4ms/pcb-Kit-Trig-Sampler/faceplate/p1/artwork sources/artwork.png

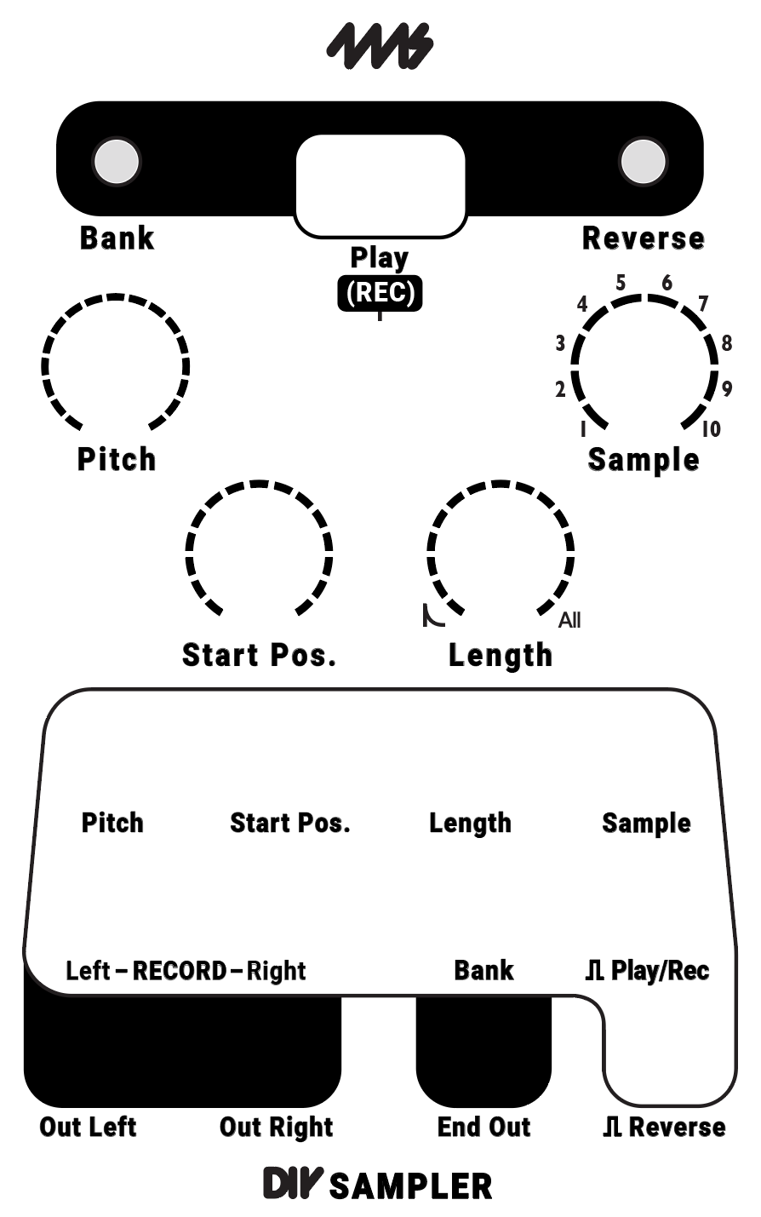
faceplate/p1/artwork sources/artwork.png
