4ms/pcb-Kit-Trig-Sampler/faceplate/p1/artwork sources/DIY_Sampler_JQ3_artwork1.png

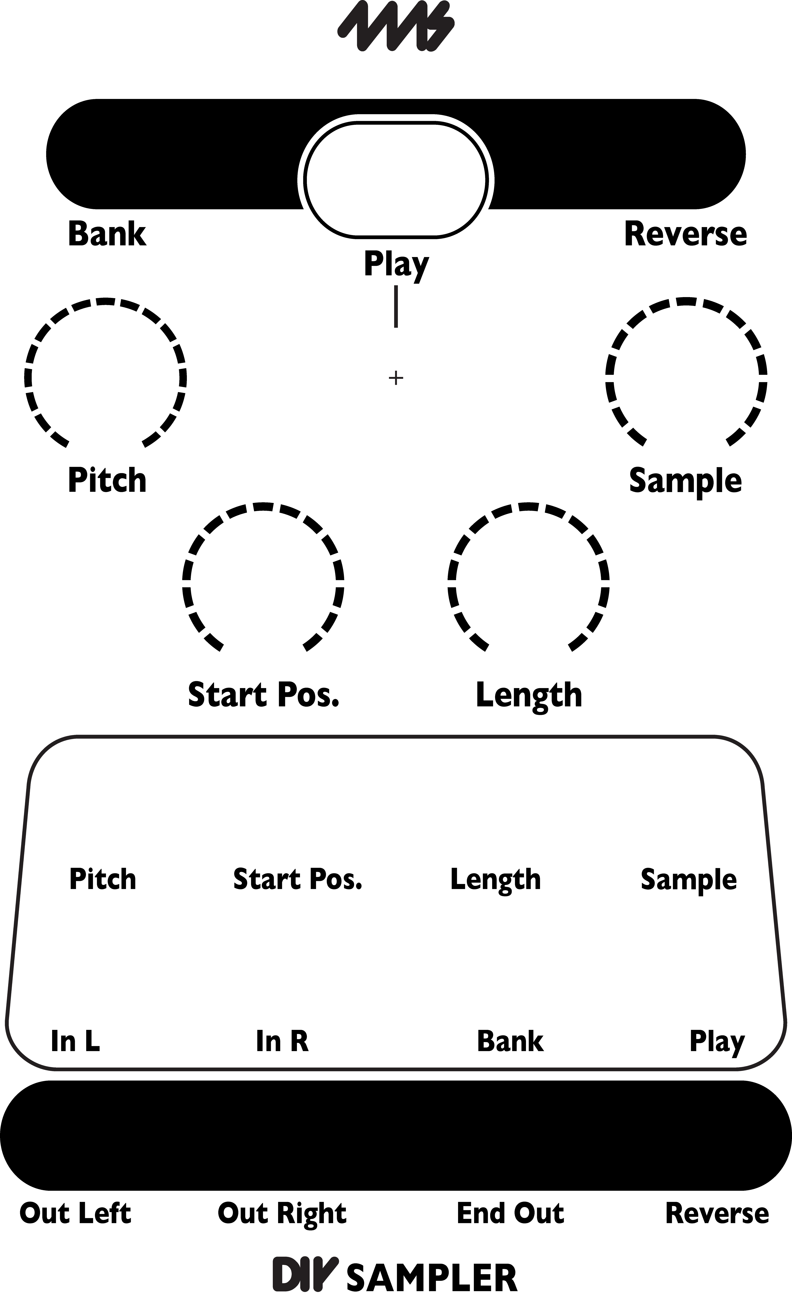
faceplate/p1/artwork sources/DIY_Sampler_JQ3_artwork1.png
