4ms/pcb-Kit-Trig-Sampler/faceplate/p1/artwork sources/DIY_Sampler_JQ8c_artwork.png

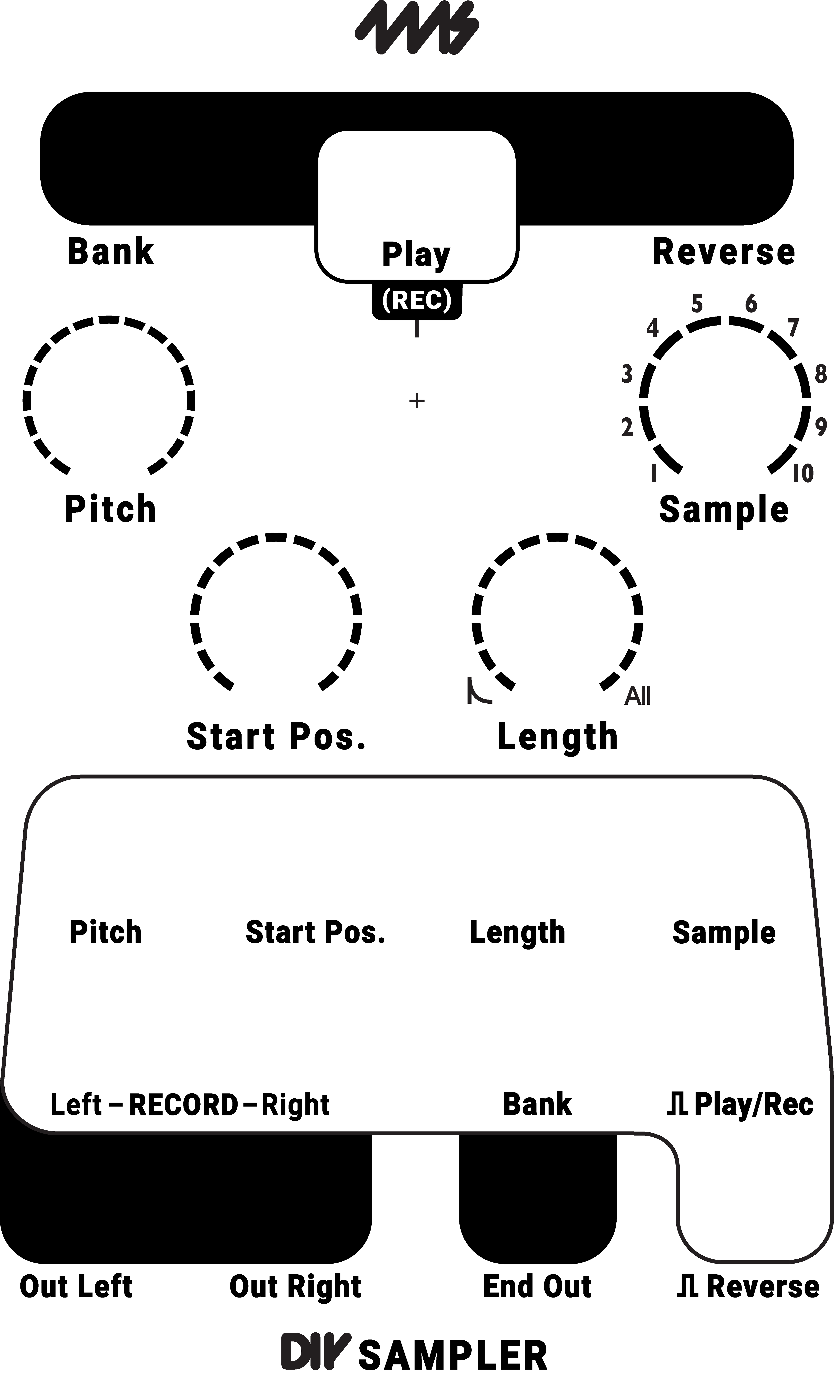
faceplate/p1/artwork sources/DIY_Sampler_JQ8c_artwork.png
