4ms/pcb-Kit-Trig-Sampler/v1.0-kit/kit-sampler-v1.0-project/not used/Kit-Sampler-v1.0-bom-posin.xlsx

Kit-Sampler
4ms Company
PCBA Project: | Kit-Sampler | Revision: | v1.0
EMAIL: | 4ms@4mscompany.com
DATE: | 2023-03-28
Group | Item# | Manufacturer | Manufacter Part# | Designator | Quantity | Designation | Package | Comments | Supplied by:
A | 1 |  |  |  | 1 | Plastic Bag with zip closure. Width: 50mm-90mm, Height: 75mm-150mm. |  |  | Posin
B | 2 | Vishay | K104Z15Y5VF53L2 | C1, C2, C3, C7, C8, C9, C10, C12, C13, C14, C15, C16, C17 | 13 | 0.1uF_Disc_TH, MLCC, Leaded, Min 25V, Y5V, Lead Spacing 2.5mm, Body approx 4x4mm | C_Disc_P2.54mm |  | Posin
B | 3 | Panasonic | ECA-1VM470I | C4, C5, C19, C20 | 4 | 47uF_16V_TH, Aluminum Electrolytic, Radial Leaded, Min 25V, 5mm Diameter, 11mm Height, 2.5mm Lead Spacing | CP_Radial_P2.5mm |  | Posin
B | 4 | Nichicon | QYX2A102KTP1FD | C6 | 1 | 1nF_Disc_TH, Film Capacitor, Min 25V, Max 20% tolerance, Lead Spacing 5mm, Body 5mm(W) x 8.5mm(H) | C_Disc_P5.08mm |  | Posin
B | 5 | Vishay | D101K20Y5PL6TJ5R | C11 | 1 | 100pF_Disc_TH, Ceramic Disc, Max 20% tolerance, 5mm Lead Spacing, 5mm Diameter | C_Disc_P5.08mm |  | Posin
B | 6 | Vishay | SB140-E3/54 | D1, D2 | 2 | SB140-E3_TH, SCHOTTKY RECTIFIER 1.0A 40Vrrm 0.48Vf | D_DO-35_P7.62mm_Horizontal |  | Posin
B | 7 | TAD | 1-1002FBV0T | J14 | 1 | Eurorack_Power_10pin_Unshrouded, HEADER 2x5 MALE PINS 0.100” 180deg | Pins_2x05_2.54mm_TH_Europower |  | Posin
B | 8 | Samtec | SSW-105-01-T-D | JA1, JB1, JC1, JD1 | 4 | Socket_02x05_P2.54mm_TH, HEADER 2x5 FEMALE SOCKET 0.100” 180deg | Socket_2x05_2.54mm_TH |  | Posin
B | 9 | Xicon | 299-1k-RC | R1, R15, R16, R21, R40, R41 | 6 | 1k_TH0.125, 1k, 5%, 1/8W, TH0.125 | R_Axial_DIN0207_L6.3mm_D2.5mm_P7.62mm_Horizontal |  | Posin
B | 10 | Xicon | 299-47k-RC | R2, R3, R4, R14, R17, R20, R27, R33 | 8 | 47k_TH0.125, 47k, 5%, 1/8W, TH0.125 | R_Axial_DIN0207_L6.3mm_D2.5mm_P7.62mm_Horizontal |  | Posin
B | 11 | Xicon | 299-100k-RC | R5, R6, R7, R8, R34 | 5 | 100k_TH0.125, 100k, 5%, 1/8W, TH0.125 | R_Axial_DIN0207_L6.3mm_D2.5mm_P7.62mm_Horizontal |  | Posin
B | 12 | Xicon | 299-10k-RC | R9, R12, R25, R26, R37 | 5 | 10k_TH0.125, 10k, 5%, 1/8W, TH0.125 | R_Axial_DIN0207_L6.3mm_D2.5mm_P7.62mm_Horizontal |  | Posin
B | 13 | Xicon | 299-33k-RC | R10, R11, R13, R28, R30, R31, R32 | 7 | 33k_TH0.125, 33k, 5%, 1/8W, TH0.125 | R_Axial_DIN0207_L6.3mm_D2.5mm_P7.62mm_Horizontal |  | Posin
B | 14 | Xicon | 299-330-RC | R18, R19, R23 | 3 | 330Ω_TH0.125, 330Ω, 5%, 1/8W, TH0.125 | R_Axial_DIN0207_L6.3mm_D2.5mm_P7.62mm_Horizontal |  | Posin
C | 15 | TE Connectivity | 1-2199298-2 | SK1, SK2 | 2 | DIP-8 Socket, 2.54mm Pitch, 7.62mm Rows |  |  | Posin
C | 16 | Texas Instruments | TL072IP | U1, U2 | 2 | TL072_TH, Dual Opamp DIP-8 JFET Input, Low Noise, Min 24Vpp Vsupply, 13V/us, 3MHz GBP | DIP-8pin_TH |  | Posin
D | 17 | Posin | kit-sampler-faceplate-v1.0 | FP1 | 1 | Faceplate, Kit Sampler Faceplate, matte black mask, white silk |  |  | Posin
D | 18 | Posin | kit-sampler-v1.0 | PCB1 | 1 | PCB, green mask, white silk, FR4 1.6mm, HASL-LF, two layer |  |  | Posin
