4ms/pcb-Kit-Trig-Sampler/faceplate/p1/artwork sources/DIY_Sampler_JQ5.dxf

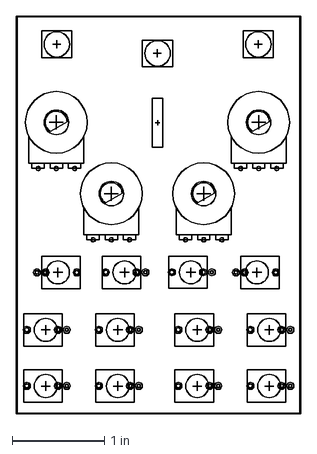
[picture p5: CAD file, 2023-01-18]
faceplate/p1/artwork sources/DIY_Sampler_JQ5.dxf
3.08 x 4.31 in
