4ms/pcb-Kit-Trig-Sampler/faceplate/p1/artwork sources/DIY_Sampler_JQ4.dxf

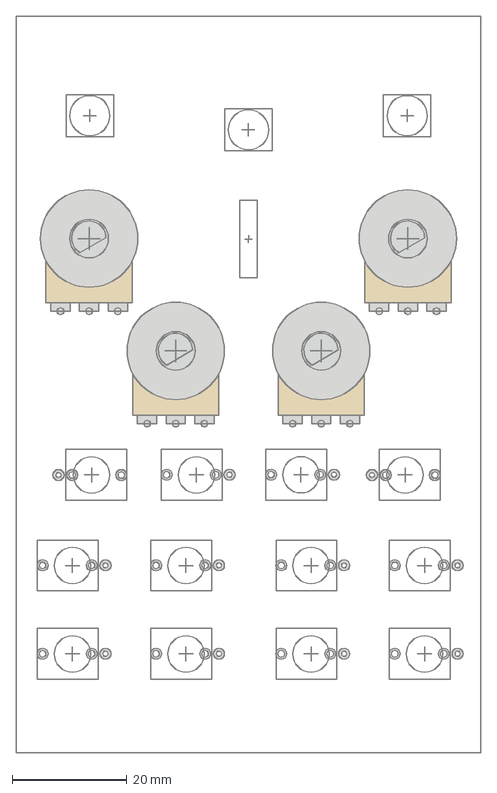
[picture p6: CAD file, 2023-01-17]
faceplate/p1/artwork sources/DIY_Sampler_JQ4.dxf
81.0 x 128.5 mm
