4ms/pcb-Kit-Trig-Sampler/faceplate/p1/artwork sources/DIY_Sampler_JQ3_mount1.dxf

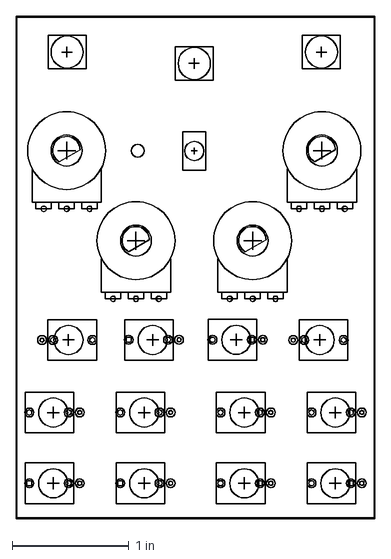
[picture p7: CAD file, 2023-01-17]
faceplate/p1/artwork sources/DIY_Sampler_JQ3_mount1.dxf
3.08 x 4.31 in
