4ms/pcb-Kit-Trig-Sampler/v1.0-kit/kit-sampler-v1.0-project/not used/instructions.pdf

### Kit-Sampler Parts Instructions

See BOM column "Group".

1) Group B (resistors, capacitors, diodes, headers) placed into a clear plastic bag (Item 1)
2) Group C (Items 15 and 16: ICs and IC sockets) placed on foam OR placed in IC tube:

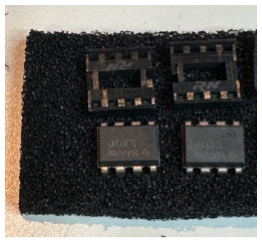
[picture p8: figure]
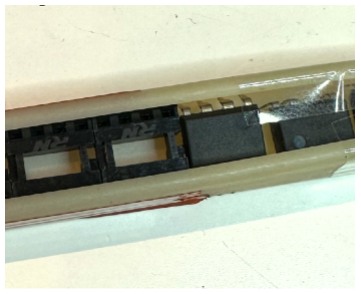
[picture p9: figure]

3) Group C placed into plastic bag (Item 1). Photo shows foam option.

Foam or tube is OK.

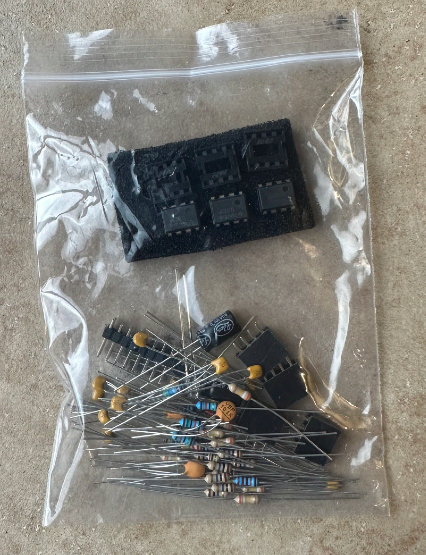
[picture p10: figure]

4) PCBs and faceplate PCBs (Items 17 and 18) can be shipped together in bulk

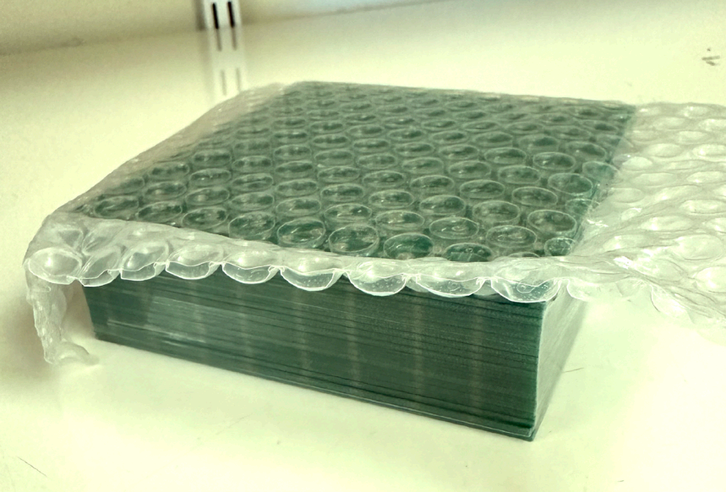
[picture p11: figure]
