4ms/pcb-Kit-Trig-Sampler/(threads)

Thread 1 (2023-03-21):

Play Trig jack need to be on protected pin

danngreen, 2023-03-21:
on p3, Play Trig jack goes to D13. But this pin is not protected on the brainboard. So it needs to change to D0, D1, D2, or D3.
D0 is Bank LED Green
D1 is Bank LED Red
D2 is already used by the other trigger input (Rev).
D3 is Rev LED Blue

Here's one solution:

Change Bank Button (D6) to use D13
Change Play Trig (D13) to use D0
Change Bank LED Green (D0) to use D6

Alternatively, we could leave the brainboard connections the same and add a 1k resistor, a 10nF cap, and two diodes to the Kit PCB (same setup as the 2k resistor and BAT54 on the brainboard D0 pin). But this is more parts and swapping the pins is better in the long run

danngreen, 2023-03-21:
Here's another solution:
We could just add a 1k resistor to the Sampler Kit PCB in series with the Play jack. This could be done on the protos that arrive this week easily (requires cutting the trace, though).
Then we add a BAT54S on the brain boards on pin D13. This does not require any trace-cutting, just soldering the BAT54S to the pin header and running wires to GND and +3.3V.

danngreen, 2023-03-21:
We have a similar issue on the LD too...

danngreen, 2023-03-21:
Chosen Solution:
Add 10k resistor on Sampler Kit in series with Play Jack.
Add BAT54S on pin D13 on brainboards. Also add more BAT54S on other digital pins

danngreen, 2023-03-23:
Actually, we are adding 47k resistors, not 10k to all Trigger input jacks

danngreen, 2023-03-24:
Fixed on p5 brainboards, and p3/p3-SMT Samplers

danngreen, 2023-03-26:
Cut traces and add 47k to on sampler-p2 unit that arrived March 24

Closed 2023-03-26.

Thread 2 (2023-03-23):

Pitch CV range should be more favored towards higher pitches

danngreen, 2023-03-23:
Currently is -5V to +5V, but -2 to +8V would be better.

Changing the offset resistor would fix it

danngreen, 2023-03-29:
Tried it out on a branch, by using a 47k instead of R9+R37(10k+10k). Makes the pitch CV respond from -2.25V to +7.75V. Adjusted volt oct compensation and lookup table.
Unable to play stereo 16b samples past around 4-5 octaves up anyways.

Doing this would allow you to turn the Pitch knob all the way down and then use CV to go up 8 octaves, but with the pitch knob centered it glitches too much.

Closing, no changes will be made

Closed 2023-03-29.
