4ms/pcb-Kit-Trig-Sampler/v1.0-kit/pdf/DIY-Sampler-Kit-schematic.pdf

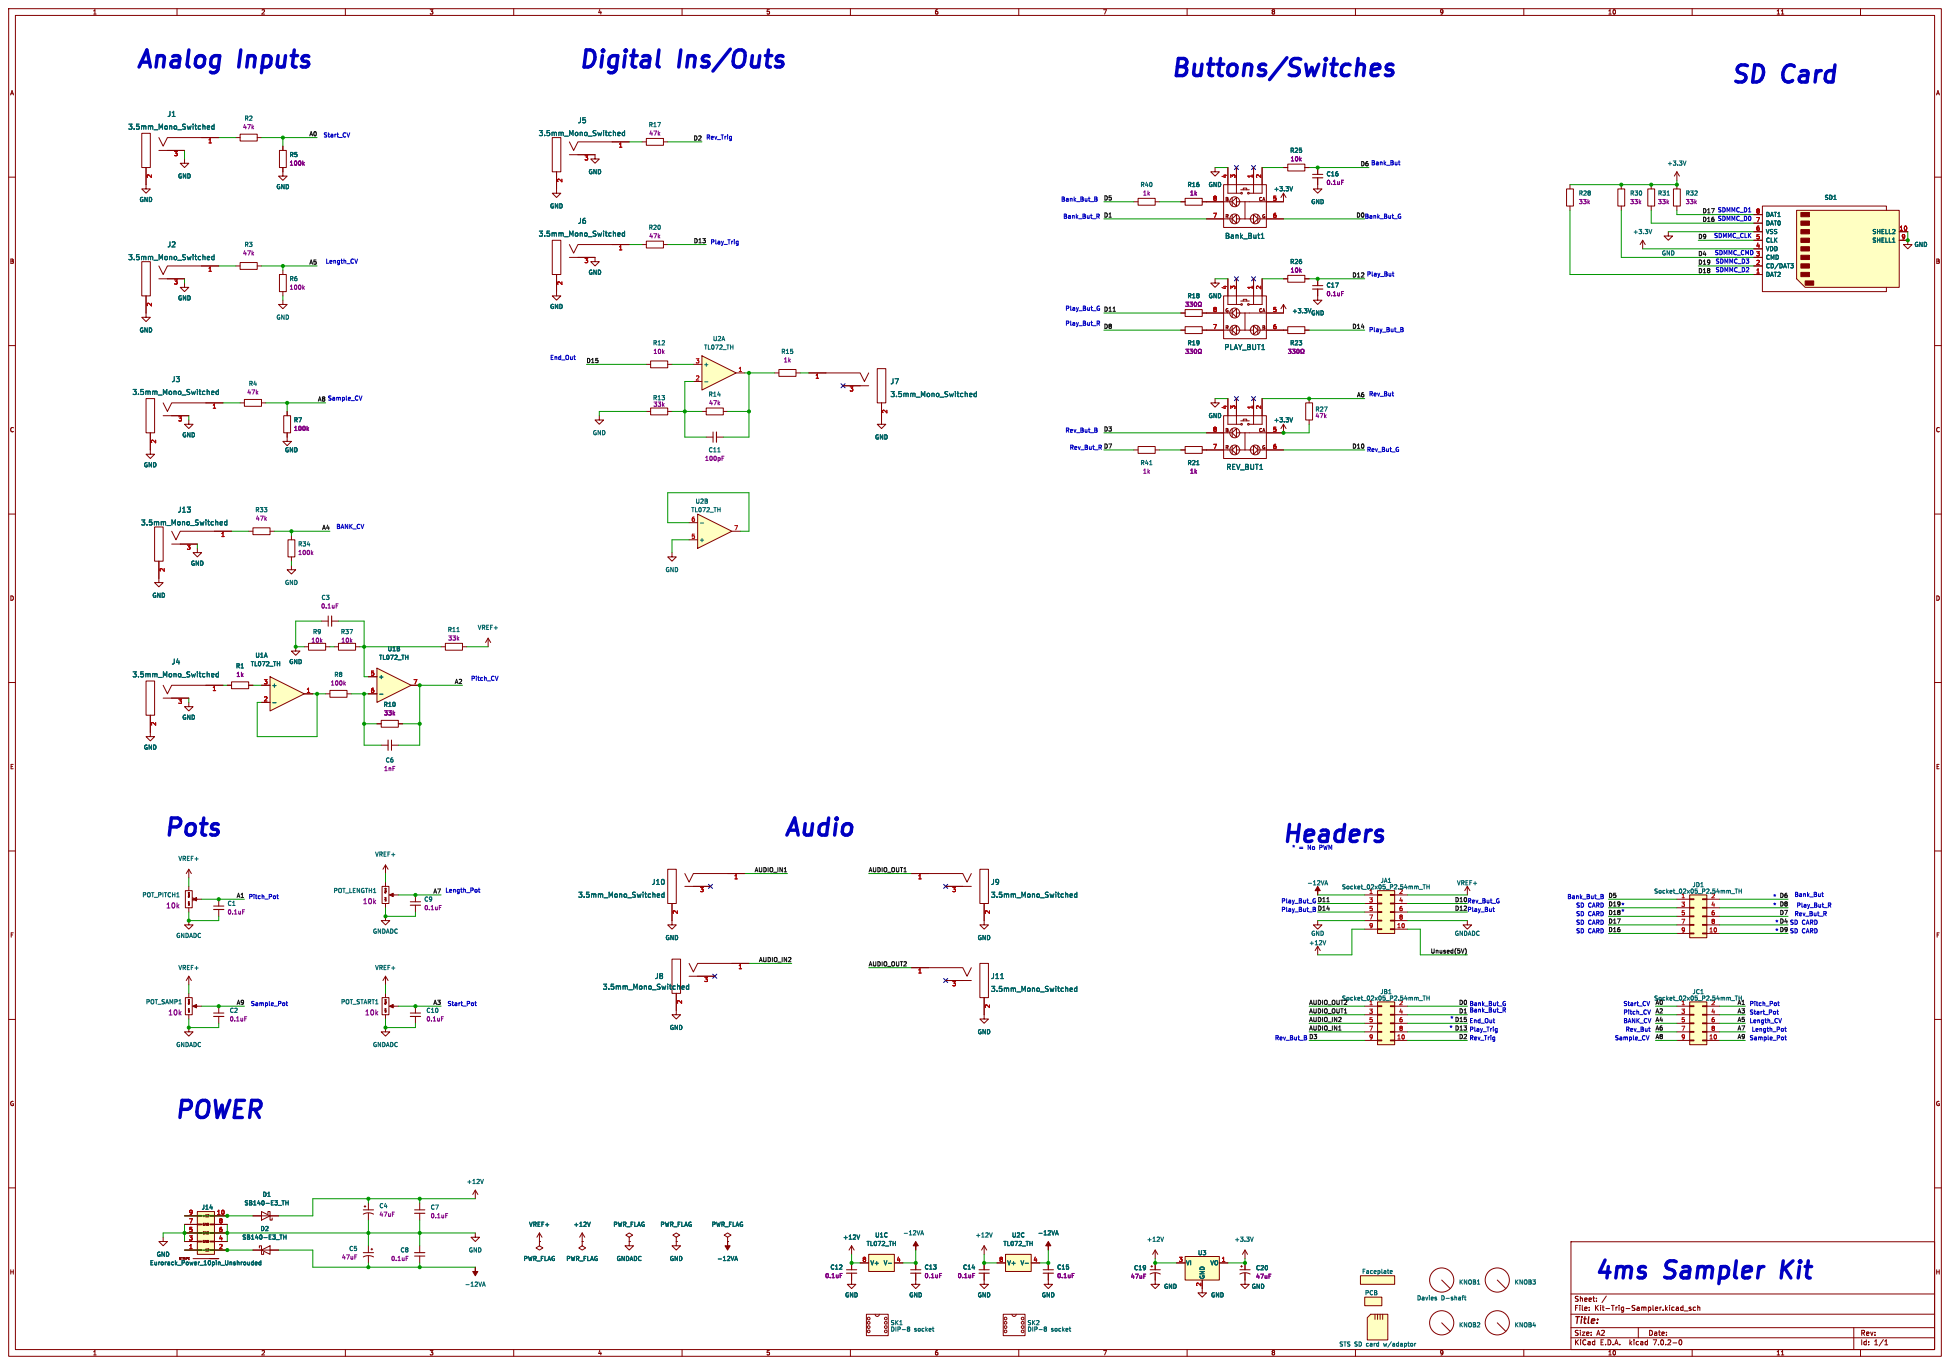
[picture p12: page 1]

STS SD card w/adaptor
