4ms/pcb-Kit-Trig-Sampler/(commit log)

2022-10-17 Started Schematic
    Updated all parts to current 4ms library
    [Kit-Trig-Sampler.kicad_pcb, Kit-Trig-Sampler.kicad_sch]
2023-01-05 STS kit
    schematic drawin
    [Kit-Trig-Sampler.kicad_pcb, Kit-Trig-Sampler.kicad_sch]
2023-01-05 forgotten push
    [Kit-Trig-Sampler.kicad_sch]
2023-01-05 part placement
    [Kit-Trig-Sampler.kicad_pcb, Kit-Trig-Sampler.kicad_sch]
2023-01-05 Small changes to pin assignments
    [Kit-Trig-Sampler.kicad_pcb, Kit-Trig-Sampler.kicad_sch]
2023-01-05 added Bank cv
    [Kit-Trig-Sampler.kicad_pcb, Kit-Trig-Sampler.kicad_sch]
2023-01-06 part placement ip
    [Kit-Trig-Sampler.kicad_pcb, Kit-Trig-Sampler.kicad_sch]
2023-01-09 part placement pending approval
    [Kit-Trig-Sampler.kicad_pcb]
2023-01-09 small updates
    [Kit-Trig-Sampler.kicad_pcb, Kit-Trig-Sampler.kicad_sch]
2023-01-09 ignore .kicad_prl files
2023-01-10 Finished routing
    needs a once over and silk arrangement.
    [Kit-Trig-Sampler.kicad_pcb, Kit-Trig-Sampler.kicad_sch]
2023-01-11 finished routing and silk arrangement
    ready for review
    [Kit-Trig-Sampler.kicad_pcb]
2023-01-13 nudged some parts in accordance to FP update
    [Kit-Trig-Sampler.kicad_pcb, Kit-Trig-Sampler.kicad_sch]
2023-01-13 nudged some parts for to match DLD layout
    [Kit-Trig-Sampler.kicad_pcb]
2023-01-14 small update to silk
    [Kit-Trig-Sampler.kicad_pcb]
2023-01-17 fixed artwork files (JQ revision 3)
    [DIY_Sampler_JQ3_mount1.dxf]
2023-01-17 Added rev4 artwork AI and DXF
    [DIY_Sampler_JQ4.dxf]
2023-01-17 updates to part placement
    so it matches the faceplate
    [Kit-Trig-Sampler.kicad_pcb]
2023-01-18 Rev5 of Artwork
    [DIY_Sampler_JQ5.dxf]
2023-01-18 created faceplate p1 project
    [Kit-Trig-Sampler-faceplate.kicad_pcb]
2023-01-18 JLCPCB prep
    [Kit-Trig-Sampler.kicad_pcb, bom.csv, designators.csv, positions.csv]
2023-01-20 changes to schem and layout
    [Kit-Trig-Sampler.kicad_pcb, Kit-Trig-Sampler.kicad_sch]
2023-01-20 updates to PCB. arrangement of silk.
    [Kit-Trig-Sampler.kicad_pcb]
2023-01-23 Fixed R13 value (was 68k, should be 33k)
    [Kit-Trig-Sampler.kicad_sch]
2023-01-23 Resistor Consolidation
    and updates to Button LEDS
    [Kit-Trig-Sampler.kicad_pcb, Kit-Trig-Sampler.kicad_sch]
2023-01-23 Resistor consolidation
    [Kit-Trig-Sampler.kicad_pcb]
2023-01-25 minor changes to silk
    [Kit-Trig-Sampler.kicad_pcb, bom.csv, designators.csv, positions.csv]
2023-02-18 p2 started
    [Kit-Trig-Sampler-faceplate.kicad_pcb, Kit-Trig-Sampler.kicad_pcb, Kit-Trig-Sampler.kicad_sch, bom.csv, designators.csv, positions.csv]
2023-02-18 Rotated power header
    repositioned R13 and 47uF caps at top of board
    [Kit-Trig-Sampler.kicad_pcb]
2023-03-06 power header swapped for 10 pin
    [Kit-Trig-Sampler.kicad_pcb, Kit-Trig-Sampler.kicad_sch]
2023-03-06 Moved p1 artwork files to faceplate/p1 folder
    [DIY_Sampler_JQ3_mount1.dxf, DIY_Sampler_JQ4.dxf, DIY_Sampler_JQ5.dxf]
2023-03-06 Fix audio jack positions on schematic
    [Kit-Trig-Sampler.kicad_sch]
2023-03-06 Added note about D5 going to two LEDs
    [Kit-Trig-Sampler.kicad_sch]
2023-03-07 Assigned Rev_But_B to pin D3 (instead of D5, which is used by Bank_But_B)
    [Kit-Trig-Sampler.kicad_sch]
2023-03-07 Fixed D5 redundancy
    [Kit-Trig-Sampler.kicad_pcb, Kit-Trig-Sampler.kicad_sch]
2023-03-07 updated p2 faceplate
    [Kit-Trig-Sampler-FACEPLATE-B_Cu.gbl, Kit-Trig-Sampler-FACEPLATE-B_Mask.gbs, Kit-Trig-Sampler-FACEPLATE-Edge_Cuts.gm1, Kit-Trig-Sampler-FACEPLATE-F_Cu.gtl, Kit-Trig-Sampler-FACEPLATE-F_Mask.gts, Kit-Trig-Sampler-FACEPLATE-F_Silkscreen.gto, Kit-Trig-Sampler-FACEPLATE-drl_map.gbr, Kit-Trig-Sampler-FACEPLATE-job.gbrjob]
2023-03-11 STS P2 updated to fix LED brightness issue on buttons
    [Kit-Trig-Sampler.kicad_pcb, Kit-Trig-Sampler.kicad_sch]
2023-03-13 Rev But gets pull-up, no cap. Remove SD-D3 resistor
    [Kit-Trig-Sampler.kicad_sch]
2023-03-13 P2: updates from schem, rerouted GND near 3v3. Rotated SD card 180
    [Kit-Trig-Sampler.kicad_pcb]
2023-03-13 P2: updated from schem, rerouted GND near 3v3. Rotated SD card 180
    [Kit-Trig-Sampler.kicad_pcb]
2023-03-17 p2: generated production files
    [bom.csv, designators.csv, positions.csv]
2023-03-17 p2: regenerated prodcution files...
    [Kit-Trig-Sampler.kicad_pcb]
2023-03-17 P2-SMT: conversion and pcb complete +faceplate
    [Kit-Trig-Sampler-FACEPLATE-B_Cu.gbl, Kit-Trig-Sampler-FACEPLATE-B_Mask.gbs, Kit-Trig-Sampler-FACEPLATE-B_Paste.gbp, Kit-Trig-Sampler-FACEPLATE-B_Silkscreen.gbo, Kit-Trig-Sampler-FACEPLATE-Edge_Cuts.gm1, Kit-Trig-Sampler-FACEPLATE-F_Cu.gtl, Kit-Trig-Sampler-FACEPLATE-F_Mask.gts, Kit-Trig-Sampler-FACEPLATE-F_Paste.gtp]
2023-03-20 Small tweeks to p2 smt routing
    [Kit-Trig-Sampler.kicad_pcb]
2023-03-20 p2-SMT nudged traces to keep PWMs away from CV jacks
    [Kit-Trig-Sampler.kicad_pcb]
2023-03-21 p2 SMT: swapped out U3 for different regulator
    [Kit-Trig-Sampler.kicad_pcb, Kit-Trig-Sampler.kicad_sch]
2023-03-22 changed the p number to 3 on SMT version so it'll be in synch with non-smt
    [Kit-Trig-Sampler.kicad_pcb, Kit-Trig-Sampler.kicad_sch, bom.csv, designators.csv, positions.csv]
2023-03-22 created p3
    [Kit-Trig-Sampler.kicad_pcb, Kit-Trig-Sampler.kicad_sch, bom.csv, designators.csv, positions.csv]
2023-03-22 p3: added 47k resistors to Trig Ins
    [Kit-Trig-Sampler.kicad_pcb, Kit-Trig-Sampler.kicad_sch]
2023-03-22 p3 SMT: added 47K resistors to Trig Ins
    [Kit-Trig-Sampler.kicad_pcb, Kit-Trig-Sampler.kicad_sch]
2023-03-22 p2 smt: regenerated fp
    [Kit-Trig-Sampler-FACEPLATE-B_Cu.gbl, Kit-Trig-Sampler-FACEPLATE-B_Mask.gbs, Kit-Trig-Sampler-FACEPLATE-B_Paste.gbp, Kit-Trig-Sampler-FACEPLATE-B_Silkscreen.gbo, Kit-Trig-Sampler-FACEPLATE-Edge_Cuts.gm1, Kit-Trig-Sampler-FACEPLATE-F_Cu.gtl, Kit-Trig-Sampler-FACEPLATE-F_Mask.gts, Kit-Trig-Sampler-FACEPLATE-F_Paste.gtp]
2023-03-22 p3: generated production files
    [Kit-Trig-Sampler.kicad_pcb]
2023-03-22 p3 smt: generated prod files
    [Kit-Trig-Sampler.kicad_pcb, bom.csv, designators.csv, positions.csv]
2023-03-22 p3 smt: redid faceplate
    [Kit-Trig-Sampler-FACEPLATE-B_Cu.gbl, Kit-Trig-Sampler-FACEPLATE-B_Mask.gbs, Kit-Trig-Sampler-FACEPLATE-Edge_Cuts.gm1, Kit-Trig-Sampler-FACEPLATE-F_Cu.gtl, Kit-Trig-Sampler-FACEPLATE-F_Mask.gts, Kit-Trig-Sampler-FACEPLATE-F_Silkscreen.gto, Kit-Trig-Sampler-FACEPLATE-drl_map.gbr, Kit-Trig-Sampler-FACEPLATE-job.gbrjob]
2023-03-28 WIP: idea for SMT version with no brainboard
    [Kit-Trig-Sampler.kicad_pcb, Kit-Trig-Sampler.kicad_sch, bom.csv, designators.csv, positions.csv]
2023-03-29 updating sch with BOM info
    [Kit-Trig-Sampler.kicad_sch]
2023-03-29 Update instructions.pdf, update BOM, export Gerbers
    [Kit-Sampler-v1.0-bom-posin.xlsx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]
2023-03-29 faceplate p3: Fix DIY marking more legible
    [Kit-Sampler-faceplate-B_Cu.gbl, Kit-Sampler-faceplate-B_Mask.gbs, Kit-Sampler-faceplate-Edge_Cuts.gm1, Kit-Sampler-faceplate-F_Cu.gtl, Kit-Sampler-faceplate-F_Mask.gts, Kit-Sampler-faceplate-F_Silkscreen.gto, Kit-Sampler-faceplate-drl_map.gbr, Kit-Sampler-faceplate.drl]
2023-03-29 Add gerbers to send to Posin
2023-03-29 Create p3 kit project files for Posin
    [Kit-Sampler-v1.0-bom-posin.xlsx]
2023-03-29 p3-SMT: Updated all syms from lib
    [Kit-Trig-Sampler.kicad_sch]
2023-03-29 p3-SMT: update socket symbols, add PCB/faceplate/knob symbols
    [Kit-Trig-Sampler.kicad_sch]
2023-03-29 p3-SMT: generate BOM (first pass)
    [Kit-Trig-Sampler.csv]
2023-03-29 finish p3-SMT BOM. Update all headers to non-gold
    [Kit-Sampler-v1.0-bom-posin.xlsx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]
2023-04-06 Created v1.0 kit and built (aka p4-SMT).
    kit: fixed footprint for regulator
    built: also fixed footprint/connections for regulator
    updated silk to say 1.0
    [Kit-Sampler-v1.0-bom-posin.xlsx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]
2023-04-06 Rename p4-SMT => v1.0-built
    [Kit-Trig-Sampler-B_Cu.gbr, Kit-Trig-Sampler-B_Mask.gbr, Kit-Trig-Sampler-B_Silkscreen.gbr, Kit-Trig-Sampler-Edge_Cuts.gbr, Kit-Trig-Sampler-F_Cu.gbr, Kit-Trig-Sampler-F_Mask.gbr, Kit-Trig-Sampler-F_Paste.gbr, Kit-Trig-Sampler-F_Silkscreen.gbr]
2023-04-06 Renamed "Kit-Trig-Sampler" SMT => Sampler-built
    [Kit-Trig-Sampler-all-pos.csv, Sampler-built-B_Cu.gbr, Sampler-built-B_Mask.gbr, Sampler-built-B_Silkscreen.gbr, Sampler-built-Edge_Cuts.gbr, Sampler-built-F_Cu.gbr, Sampler-built-F_Mask.gbr, Sampler-built-F_Paste.gbr]
2023-04-06 Add BOM costs for v1.0 kit and built
    [Kit-Sampler-v1.0-bom-posin_(20230404 cost).xlsx, Sampler-v1.0-bom-posin_(20230331 cost).xlsx]
2023-04-10 Faceplate p3 smt: corrections to faceplate.
    fixed sd card slot size
    [Kit-Trig-Sampler-FACEPLATE-B_Cu.gbl, Kit-Trig-Sampler-FACEPLATE-B_Mask.gbs, Kit-Trig-Sampler-FACEPLATE-Edge_Cuts.gm1, Kit-Trig-Sampler-FACEPLATE-F_Cu.gtl, Kit-Trig-Sampler-FACEPLATE-F_Mask.gts, Kit-Trig-Sampler-FACEPLATE-F_Silkscreen.gto, Kit-Trig-Sampler-FACEPLATE-job.gbrjob, Kit-Trig-Sampler-FACEPLATE.drl]
2023-04-11 Added zip file of p3-smt faceplate (Sampler-faceplate-v1.0a)
2023-04-11 v1.0-kit: updated BOM (new TH part numbers to match what we actually use)
    [Kit-Trig-Sampler.kicad_sch]
2023-04-18 Kit BOM updated with parts we have in stock
2023-04-18 Updated kit BOM with actual parts used
2023-04-27 Renamed faceplate/p3-smt => faceplate/v1.0-built
    [Kit-Trig-Sampler-FACEPLATE-B_Cu.gbl, Kit-Trig-Sampler-FACEPLATE-B_Mask.gbs, Kit-Trig-Sampler-FACEPLATE-Edge_Cuts.gm1, Kit-Trig-Sampler-FACEPLATE-F_Cu.gtl, Kit-Trig-Sampler-FACEPLATE-F_Mask.gts, Kit-Trig-Sampler-FACEPLATE-F_Silkscreen.gto, Kit-Trig-Sampler-FACEPLATE-job.gbrjob, Kit-Trig-Sampler-FACEPLATE.drl]
2023-04-27 Renamed faceplate/p3 => faceplate/v1.0-kit
    [Kit-Sampler-faceplate-B_Cu.gbl, Kit-Sampler-faceplate-B_Mask.gbs, Kit-Sampler-faceplate-Edge_Cuts.gm1, Kit-Sampler-faceplate-F_Cu.gtl, Kit-Sampler-faceplate-F_Mask.gts, Kit-Sampler-faceplate-F_Silkscreen.gto, Kit-Sampler-faceplate-drl_map.gbr, Kit-Sampler-faceplate.drl]
2023-04-27 BOM cleanup/organization
2024-03-19 V1.1-rc-1-12HP
    created folder, updated schem, suggested layout
    [Sampler-built-B_Cu.gbr, Sampler-built-B_Mask.gbr, Sampler-built-B_Silkscreen.gbr, Sampler-built-Edge_Cuts.gbr, Sampler-built-F_Cu.gbr, Sampler-built-F_Mask.gbr, Sampler-built-F_Paste.gbr, Sampler-built-F_Silkscreen.gbr]
2024-03-20 v1.0 kit schematic PDF
2024-03-20 Proofed and fixed v1.1rc1_12HP schematic. Some schematic TODO left
    [Sampler-built.kicad_sch]
2024-03-21 v1.1-rc1-12HP: part placement and routing ip
    [Sampler-built.kicad_pcb, Sampler-built.kicad_sch]
2024-03-21 v1.1 rc1 12hp: routing IP
    [Sampler-built.kicad_pcb]
2024-04-02 v1.1-rc1-12HP: finished routing and silk
    [Sampler-built.kicad_pcb]
2024-04-02 Removed extra EdgeCuts line
    [Sampler-built.kicad_pcb]
2024-04-05 Re-routing in progress
    TODO:
    - A2 (PitchCV) on red layer, routing CCW from ARM pin to opamp, avoiding digital lines
    - Put SAI/I2C traces that are north of ARM => to orange layer
    - Put digital red traces in the area under the START1_POT => to blue/orange layer
    - Move VREF/GNDADC to red layer (might need to go to orange layer when crossing board east->west
    - Move U6 to near V2, using the nettie for GNDADC-GND for U6
    [Sampler-built.kicad_pcb, Sampler-built.kicad_sch]
2024-04-05 Updates to pcb / routing for noise mitigation
    [Sampler-built.kicad_pcb, Sampler-built.kicad_sch]
2024-04-08 Routing: Moved all digital traces under START POT to blue layer
    Simplified lots of digital routing in that area
    Made analog routing more strictly stay on red side
    Moved VREF/GNDADC connection to ARM away from inductor
    [Sampler-built.kicad_pcb]
2024-04-09 Minor Schem cleanup
    only changes to clean up appearance, no changes to routing
    [Sampler-built.kicad_sch]
2024-04-09 12HP-v1.1rc1 faceplate - Finished artwork, exported PNG, converted to footprint
    [Sampler-built.kicad_sch]
2024-04-10 Set kicad.pro file back to kicad v7
2024-04-10 SCH: Updated STM chip (U2) to use new library part.
    Set kicad.sch file back to v7
    [Sampler-built.kicad_sch]
2024-04-10 PCB: Fixed copper pour glitch, reconnected 3.3v, added Screen to silk and resolved DRC
    [Sampler-built.kicad_pcb]
2024-04-10 Generated production files
    [Sampler-built-B_Cu.gbr, Sampler-built-B_Mask.gbr, Sampler-built-B_Silkscreen.gbr, Sampler-built-Edge_Cuts.gbr, Sampler-built-F_Cu.gbr, Sampler-built-F_Mask.gbr, Sampler-built-F_Paste.gbr, Sampler-built-F_Silkscreen.gbr]
2024-04-10 Removed previous gerber files
    [Sampler-built-B_Cu.gbr, Sampler-built-B_Mask.gbr, Sampler-built-B_Silkscreen.gbr, Sampler-built-F_Cu.gbr, Sampler-built-F_Mask.gbr, Sampler-built-F_Paste.gbr, Sampler-built-F_Silkscreen.gbr, Sampler-built-drl_map.gbr]
2024-04-10 Generated faceplate and gerbers
    [Sampler-built-B_Cu.gbr, Sampler-built-B_Mask.gbr, Sampler-built-Edge_Cuts.gbr, Sampler-built-F_Cu.gbr, Sampler-built-F_Mask.gbr, Sampler-built-F_Silkscreen.gbr, Sampler-built-drl_map.gbr, Sampler-built.drl]
2024-04-11 SCH: Replaced NJMs with 072Hs - PCB: updated PCB from schematic
    [Sampler-built.kicad_pcb, Sampler-built.kicad_sch]
2024-04-11 Removed all production files from previous projects - and recently generated production files
    [Sampler-built-B_Cu.gbr, Sampler-built-B_Mask.gbr, Sampler-built-B_Silkscreen.gbr, Sampler-built-Edge_Cuts.gbr, Sampler-built-F_Cu.gbr, Sampler-built-F_Mask.gbr, Sampler-built-F_Paste.gbr, Sampler-built-F_Silkscreen.gbr]
2024-04-11 Generated production files and ordered
    [Sampler-built-B_Cu.gbr, Sampler-built-B_Mask.gbr, Sampler-built-B_Silkscreen.gbr, Sampler-built-Edge_Cuts.gbr, Sampler-built-F_Cu.gbr, Sampler-built-F_Mask.gbr, Sampler-built-F_Paste.gbr, Sampler-built-F_Silkscreen.gbr]
2024-05-01 v1.1-rc1-12hp FACEPLATE
    generated and ordered
    [Sampler-built-B_Cu.gbr, Sampler-built-B_Mask.gbr, Sampler-built-Edge_Cuts.gbr, Sampler-built-FACEPLATE-B_Cu.gbl, Sampler-built-FACEPLATE-B_Mask.gbs, Sampler-built-FACEPLATE-Edge_Cuts.gm1, Sampler-built-FACEPLATE-F_Cu.gtl, Sampler-built-FACEPLATE-F_Mask.gts]
2024-05-29 TODO for v1.1-rc2 (12HP)
    [Sampler-built.kicad_sch]
2024-05-29 Created rc-2
    [Sampler-built.kicad_pcb, Sampler-built.kicad_sch]
2024-09-20 v1.1rc-1 was accidentally updated from how it was produced. Reverted the folder back to an earlier commit
    [Sampler-built.kicad_pcb, Sampler-built.kicad_sch]
2024-10-05 Updated todo list and added soft start circuit. Todo: add solder jumpers
    [Sampler-built.kicad_sch]
2024-10-07 Added softstart to +/-12v rails - and solder jumpers between +12v and regulators/references
    [Sampler-built.kicad_pcb, Sampler-built.kicad_sch]
2024-10-08 added power circuit back in, ran DRC. TODO: fix silkscreen
    [Sampler-built.kicad_pcb]
2024-10-08 production files exported
    [Sampler-built-BOM.csv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]
2024-10-10 updated front panel layout. Updated PCB layout with correct interface coordinates. Redoing parts placement + routing
    [Sampler-built-BOM.csv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]
2024-10-10 moved components to rough placement, have not started routing
    [Sampler-built.kicad_pcb]
2024-10-10 board routed, running a double check on DRC
    [Sampler-built-BOM.csv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]
2024-10-10 verified DRC, fixing silkscreen next
    [Sampler-built.kicad_pcb]
2024-10-10 silkscreen fixed, DRC pass. Ready for export
    [Sampler-built.kicad_pcb]
2024-10-10 fixed silk error
    [Sampler-built.kicad_pcb]
2024-10-10 started faceplate
    [Sampler-built-FACEPLATE.kicad_pcb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]
2024-10-11 created artwork assets for frontpanel, created and verified gerbers for front panel
    [Sampler-built-FACEPLATE-B_Cu.gbr, Sampler-built-FACEPLATE-B_Mask.gbr, Sampler-built-FACEPLATE-B_Silkscreen.gbr, Sampler-built-FACEPLATE-Edge_Cuts.gbr, Sampler-built-FACEPLATE-F_Cu.gbr, Sampler-built-FACEPLATE-F_Mask.gbr, Sampler-built-FACEPLATE-F_Paste.gbr, Sampler-built-FACEPLATE-F_Silkscreen.gbr]
2024-10-24 Moved components to match new layout for looping delay. routing in progress
    [Sampler-built.kicad_pcb]
2024-10-24 routing complete, awaiting zach's review
    [Sampler-built.kicad_pcb]
2024-10-24 started making new faceplate
    [Sampler-built-FACEPLATE-B_Cu.gbr, Sampler-built-FACEPLATE-B_Mask.gbr, Sampler-built-FACEPLATE-B_Silkscreen.gbr, Sampler-built-FACEPLATE-Edge_Cuts.gbr, Sampler-built-FACEPLATE-F_Cu.gbr, Sampler-built-FACEPLATE-F_Mask.gbr, Sampler-built-FACEPLATE-F_Paste.gbr, Sampler-built-FACEPLATE-F_Silkscreen.gbr]
2024-10-24 created faceplate
    [Sampler-built-FACEPLATE-B_Cu.gbr, Sampler-built-FACEPLATE-B_Mask.gbr, Sampler-built-FACEPLATE-B_Silkscreen.gbr, Sampler-built-FACEPLATE-Edge_Cuts.gbr, Sampler-built-FACEPLATE-F_Cu.gbr, Sampler-built-FACEPLATE-F_Mask.gbr, Sampler-built-FACEPLATE-F_Paste.gbr, Sampler-built-FACEPLATE-F_Silkscreen.gbr]
2024-10-28 cleaned up traces, will rebounce gerbers
    [Sampler-built-B_Cu.gbr, Sampler-built-B_Mask.gbr, Sampler-built-B_Silkscreen.gbr, Sampler-built-Edge_Cuts.gbr, Sampler-built-F_Cu.gbr, Sampler-built-F_Mask.gbr, Sampler-built-F_Paste.gbr, Sampler-built-F_Silkscreen.gbr]
2024-10-28 production files created, boards ordered
    [Sampler-built-BOM.csv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]
2024-11-11 Created rc4 - swapped output jacks, cleaned up a few traces, and updated silk to say rc4
    [Sampler-built.kicad_pcb, Sampler-built.kicad_sch]
2024-11-11 Updated todo list
    [Sampler-built.kicad_sch]
2024-11-14 Created all JLC production files
    [Sampler-built-B_Cu.gbr, Sampler-built-B_Mask.gbr, Sampler-built-B_Silkscreen.gbr, Sampler-built-Edge_Cuts.gbr, Sampler-built-F_Cu.gbr, Sampler-built-F_Mask.gbr, Sampler-built-F_Paste.gbr, Sampler-built-F_Silkscreen.gbr]
2024-11-28 Fixed audio input jacks and reverted output jacks back to how they were setup in rc3
    [Sampler-built.kicad_pcb, Sampler-built.kicad_sch]
2024-12-03 Removed old TODO informationfrom schematic
    [Sampler-built.kicad_sch]
2024-12-03 Updated library components from library - checking DRC -In progress
    [Sampler-built.kicad_pcb]
2024-12-04 Updated majority of 0603 parts to be 0402 and matched library links so parts showup on the same line of the BOM
    [Sampler-built.kicad_pcb, Sampler-built.kicad_sch]
2024-12-04 Changed 16v 100nf caps to be 50v and apear on same BOM line
    [Sampler-built.kicad_pcb, Sampler-built.kicad_sch]
2024-12-04 Swapped position of an opamp to make trace distances shorter - generated production files
    [Sampler-built.kicad_pcb, bom.csv, designators.csv, positions.csv]
2024-12-05 Generated production files and submitted project
    [Sampler-built.kicad_pcb, Sampler-built.kicad_sch, Sampler_v1.1-rc5_BOM.csv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]
2024-12-07 Removed built versions of the sampler - this repo is for kit sampler files only
    [Kit-Trig-Sampler-B_Cu.gbr, Kit-Trig-Sampler-B_Mask.gbr, Kit-Trig-Sampler-B_Silkscreen.gbr, Kit-Trig-Sampler-Edge_Cuts.gbr, Kit-Trig-Sampler-FACEPLATE-B_Cu.gbl, Kit-Trig-Sampler-FACEPLATE-B_Mask.gbs, Kit-Trig-Sampler-FACEPLATE-Edge_Cuts.gm1, Kit-Trig-Sampler-FACEPLATE-F_Cu.gtl]
